bjornburton/champbot/README.md

Champ-like ROV, with brief submersion capability, designed to meet the demands of the Champlain Mini Maker Faire's Champbot Challenge.

Team Name: <discuss>
Team Members: Father and son, so far

This project will be on a very tight budget but the intent is to win!
