bjornburton/champbot/Firmware/jawAndFireControl/jafco.pdf

§1 | JAFCO | INTRODUCTION | 1

September 23, 2015 at 21:20

1. | Introduction. | This is the firmware portion of Jaw and Fire control.
This will facilitate two actions: opening the jaw to release the floating object and light the target on fire. The jaw will close by return-spring so the action will to open it.
Fire is a sequence of opening the jaw, releasing the butane and firing the ignitor.

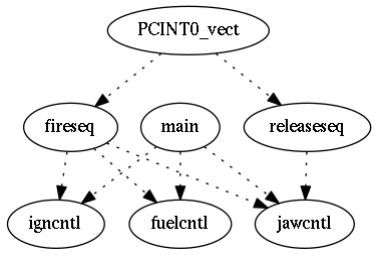
[picture p3: figure]

Extensive use was made of the datasheet, Atmel “Atmel ATtiny25, ATtiny45, ATtiny85 Datasheet” Rev. 2586QAVR08/2013 (Tue 06 Aug 2013 03:19:12 PM EDT) and “AVR130: Setup and Use the AVR Timers” Rev. 2505AAVR02/02.
hInclude 4 i
hPrototypes 5 i
h Global variables 6 i
2. "F_CPU" is used to convey the Trinket clock rate. #define F_CPU 8000000UL
3. Here are some Boolean definitions that are used. #define ON 1
#define OFF 0

#define OPEN 1

#define CLOSE 0

#define SET 1

#define CLEAR 0

2 | INTRODUCTION | JAFCO | §4

### 4. hInclude 4 i ≡

#include <avr/io.h> | /∗ need some port access ∗/

#include <util/delay.h> | /∗ need to delay ∗/

#include <avr/interrupt.h> | /∗ have need of an interrupt ∗/

#include <avr/sleep.h> | /∗ have need of sleep ∗/

#include <avr/wdt.h> | /∗ have need of watchdog ∗/

#include <stdlib.h>

#include <stdint.h>

This code is used in section 1.

### 5. hPrototypes 5 i ≡

void jawcntl(uint8 t state ); | /∗ Jaw open and close ∗/
void fuelcntl(uint8 t state ); | /∗ Fuel on and off ∗/
void igncntl(uint8 t state ); | /∗ on and off ∗/
void releaseseq (void);
void fireseq (void);

This code is used in section 1.

6. My lone global variable is a function pointer. This lets me pass arguments to the actual interrupt handlers, should I need to. This pointer gets the appropriate function attached by one of the "ISR()" functions.
h Global variables 6 i ≡
void (∗handleirq )( ) = Λ;
int main(void)
{
hInitialize interrupts 28 i hInitialize pin inputs 27 i hInitialize pin outputs 26 i

This code is used in section 1.

7. Of course, any interrupt function requires that bit “Global Interrupt Enable” is set; usually done through calling sei(). Doing this after the pin setup is the best time.
sei( );
8. Rather than burning loops, waiting for something to happen, the “sleep” mode is used. The specific type of sleep is ‘idle’. In idle, execution stops but timers continue. Interrupts are used to wake it.
h Configure to wake upon interrupt 34 i
9. This is the loop that does the work. It should spend most of its time in sleep mode , comming out at each interrupt event.
for ( ; ; )
{
10. We don’t want anything cooking while we are asleap. igncntl(OFF);
fuelcntl(OFF);
jawcntl(CLOSE);
11. Now we wait in “idle” for any interrupt event. sleep mode ( );

§12 | JAFCO | INTRODUCTION | 3
12. If execution arrives here, some interrupt has been detected.
if (handleirq 6= Λ) /∗ not sure why it would be, but to be safe ∗/
{
handleirq ( );
handleirq = Λ; | /∗ reset so that the action cannot be repeated ∗/
} | /∗ end if handleirq ∗/
} | /∗ end for ∗/
return 0; | /∗ it’s the right thing to do! ∗/
} | /∗ end main() ∗/

4 | INTERRUPT HANDLING | JAFCO | §13
13. Interrupt Handling.
void releaseseq ( )
{
14. This sequence will proceed only while the button is held. jawcntl(OPEN);
while (¬(PINB & (1 PB3))) delay ms (10); jawcntl(CLOSE); }

15.
void fireseq ( )
{
uint8 t firingstate ;
enum firingstates {
ready , opened , warned , igniting , burning };
firingstate = ready ;
16. This sequence will proceed only while the button is held. It can terminate after any state. "_delay_ms()" is a handy macro good for 2¹⁶ milliseconds of delay.

while (¬(PINB & (1 PB4))) {

17. The jaw opens here for fire, but also partly as a warning. if (firingstate ≡ ready ) {
jawcntl(OPEN);
firingstate = opened ;
continue;
}
18. Three warning bursts from the ignitor and then a 1000 ms duck delay. if (firingstate ≡ opened ) {
for (int8 t count = 0; count < 3; count ++) {
igncntl(ON);
delay ms (100);
igncntl(OFF);
delay ms (200);
}
delay ms (1000); /∗ human duck time ∗/ firingstate = warned ;
continue;
}
19. Fuel opens for precharge, then some delay. if (firingstate ≡ warned ) {
fuelcntl(ON);
delay ms (500);
firingstate = igniting ;
continue;
}

§20 | JAFCO | INTERRUPT HANDLING | 5
20. Ignitor on, delay a short time.
if (firingstate ≡ igniting ) {
igncntl(ON);
delay ms (250);
igncntl(OFF);
firingstate = burning ;
continue;
}
21. We should have fire now, but will tend it in case of wind. if (firingstate ≡ burning ) {
delay ms (1000);
igncntl(ON);
delay ms (200);
igncntl(OFF);
continue;
}
}
22. Once the loop fails we set fuel and ignitor off and close the jaw. igncntl(OFF);
fuelcntl(OFF);
jawcntl(CLOSE); }

6 | THE ISRS | JAFCO | §23
23. The ISRs.
The ISRs are pretty skimpy as they mostly used to point handleirq ( ) to the correct function. The need for global variables is minimized.
24. This vector responds to the jaw input at pin PB3 or fire input at PB4. A simple debounce is included. ISR(PCINT0 vect)
{
const int8 t high = 32;
const int8 t low = −high ; int8 t dbp3 = 0;
int8 t dbp4 = 0;
while (abs (dbp3 ) < high ) {
if (¬(PINB & (1 PB3)) ∧ dbp3 > low) dbp3 −−; else if ((PINB & (1 PB3)) ∧ dbp3 < high ) dbp3 ++; delay ms (1);
}
while (abs (dbp4 ) < high ) {
if (¬(PINB & (1 PB4)) ∧ dbp4 > low) dbp4 −−; else if ((PINB & (1 PB4)) ∧ dbp4 < high ) dbp4 ++; delay ms (1);
}
if (dbp3 ≡ low) handleirq = &releaseseq ;
else if (dbp4 ≡ low) handleirq = &fireseq ; }

§25 | JAFCO THESE ARE THE SUPPORTING ROUTINES, PROCEDURES AND CONFIGURATION BLOCKS | 7
25. These are the supporting routines, procedures and configuration blocks.
Here is the block that sets-up the digital I/O pins.

### 26. hInitialize pin outputs 26 i ≡

{ | /∗ set the jaw port direction ∗/
DDRB |= (1 DDB0); | /∗ set the fuel port direction ∗/
DDRB |= (1 DDB1); | /∗ set the ignition port direction ∗/
DDRB |= (1 DDB2);
}

This code is used in section 6.

### 27. hInitialize pin inputs 27 i ≡

{ | /∗ set the jaw input pull-up ∗/
PORTB |= (1 PORTB3); | /∗ set the fire input pull-up ∗/
PORTB |= (1 PORTB4);
}

This code is used in section 6.

### 28. hInitialize interrupts 28 i ≡

{ | /∗ enable change interrupt for jaw input ∗/
PCMSK |= (1 PCINT3); | /∗ enable change interrupt for fire input ∗/
PCMSK |= (1 PCINT4); | /∗ General interrupt Mask register ∗/
GIMSK |= (1 PCIE);
}

This code is used in section 6.

29. Here is a simple procedure to operate the jaw.
void jawcntl(uint8 t state )
{
PORTB = state ? PORTB | (1 PORTB0) : PORTB & ∼(1 PORTB0);
}
30. Here is a simple procedure to operate the fuel.
void fuelcntl(uint8 t state )
{
PORTB = state ? PORTB | (1 PORTB1) : PORTB & ∼(1 PORTB1);
}
31. Here is a simple procedure to operate the ignition.
void igncntl(uint8 t state )
{
PORTB = state ? PORTB | (1 PORTB2) : PORTB & ∼(1 PORTB2);
}
32. See section the datasheet for details on the Watchdog Timer. We are not using it right now.

### 33. hInitialize watchdog timer 33 i ≡

{
WDTCR |= (1 WDCE) | (1 WDE);
WDTCR = (1 WDIE) | (1 WDP2); /∗ reset after about 0.25 seconds ∗/
}

8 | THESE ARE THE SUPPORTING ROUTINES, PROCEDURES AND CONFIGURATION BLOCKS JAFCO | §34
34. Setting these bits configure sleep mode() to go to “idle”. Idle allows the counters and comparator to continue during sleep.
h Configure to wake upon interrupt 34 i ≡
{
MCUCR &= ∼(1 SM1);
MCUCR &= ∼(1 SM0);
}

This code is used in section 8.
delay ms : 14, 18, 19, 20, 21, 24. abs : 24.
burning : 15, 20, 21.
CLEAR: 3.
CLOSE: 3, 10, 14, 22.
count: 18.
dbp3 : 24.
dbp4 : 24.
DDB0: 26.
DDB1: 26.
DDB2: 26.
DDRB: 26.
F_CPU: 2.
fireseq : 5, 15, 24.
firingstate : 15, 17, 18, 19, 20, 21. firingstates: 15.
fuelcntl : 5, 10, 19, 22, 30. GIMSK: 28.
handleirq : 6, 12, 23, 24.
high : 24.
igncntl : 5, 10, 18, 20, 21, 22, 31. igniting : 15, 19, 20.
int8 t: 18, 24.
ISR: 24.
jawcntl : 5, 10, 14, 17, 22, 29. low: 24.
main: 6.
MCUCR: 34.
OFF: 3, 10, 18, 20, 21, 22. ON: 3, 18, 19, 20, 21.
OPEN: 3, 14, 17.
opened : 15, 17, 18.
PB3: 14, 24.
PB4: 16, 24.
PCIE: 28.
PCINT0 vect: 24.
PCINT3: 28.
PCINT4: 28.
PCMSK: 28.
PINB: 14, 16, 24.
PORTB: 27, 29, 30, 31.
PORTB0: 29.
PORTB1: 30.

PORTB2: 31.
PORTB3: 27.
PORTB4: 27.
ready : 15, 17.
releaseseq : 5, 13, 24.
sei : 7.
SET: 3.
sleep mode : 9, 11.
SM0: 34.
SM1: 34.
state : 5, 29, 30, 31.
uint8 t: 5, 15, 29, 30, 31. warned : 15, 18, 19.
WDCE: 33.
WDE: 33.
WDIE: 33.
WDP2: 33.
WDTCR: 33.

JAFCO | NAMES OF THE SECTIONS | 9

h Configure to wake upon interrupt 34 i Used in section 8.
h Global variables 6 i Used in section 1.
hInclude 4 i Used in section 1.
hInitialize interrupts 28 i Used in section 6.
hInitialize pin inputs 27 i Used in section 6. hInitialize pin outputs 26 i Used in section 6. hInitialize watchdog timer 33 i
hPrototypes 5 i Used in section 1.
