bjornburton/champbot/Firmware/Propulsion/piruett.pdf

§1 | PIRUETT | INTRODUCTION | 1

August 12, 2015 at 08:55

1. | Introduction. | This is the firmware portion of the propulsion system for our Champbot. It features
separate thrust and steering as well as piruett turning.
This will facilitate motion by taking “thrust” and “radius” pulse-width, or PWC, inputs from the Futaba-Kyosho RC receiver and converting them to the appropriate motor actions. Thrust is Channel 2, entering analog input A1, and Radius is channel 1, at A0. The action will be similar to driving an RC car or boat. By keeping it natural, it should be easier to navigate the course than with a skid-steer style control.
We are using the Wingxing DBH-01 (B/C) and the Inputs are unique on this. The PWM logic input goes to two different pins, depending on direction! The non-PWM pin must be held low. This is a big problem since PWM outputs have dedicated pins. Two AVR timers would be needed to control two motors; waistful. The odd example in the datasheet has PWM on IN1 and LOW on IN2 for forward. For reverse, LOW on IN1 and PWM on IN2.
Rulling out multiple timers (four comparators), additional outputs, or a PLD, the best solution we could find was a adding glue logic. A single 74F02 was chosen; a quad NOR. Keeping is this simple, one gate-type

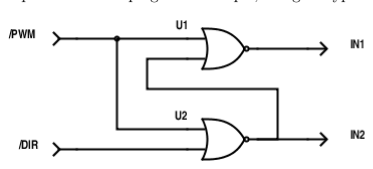
[picture p4: figure]

and one chip, required that the AVR outputs be inverted. | a
This one chip handles the logic for both motors. With this, the AVR outputs direction on one pin and PWM
on the other. At the H-Bridge, the pin receiving PWM is selected based on motor direction. The remaining,
non-PWM pin, is held low.
OC0A and OC0B is on pins 5 and 6 (D8 and D6) and are the PWM. A fail-safe relay output will be at pin 8.

2 | IMPLEMENTATION | PIRUETT | §2
2. | Implementation. | The Futaba receiver has two PWC channels. The pulse-width from the receiver
is at 20 ms intervals. The on-time ranges from 1000–2000 µs including trim. 1500 µs is the pulse-width for stop. The levers cover ±400 µs and the trim covers the last 100 µs.
The median time will be subtracted from them for a pair of signed values thrust and radius. The value will be scaled.
The thrust and radius will be translated to power to the port and starboard motors. When near median the motors will be disabled through a dead-band. Stiction in the motor probably wouldn’t allow it to move anyway, at this low duty-cycle. Both the PWM and safety relay will open. The motors will also be disabled when there are no input pulses; in this way champ wont run-off if the range is exceeded. This function is handled by the watchdog timer.
The radius control will also be the rotate control, if thrust is zero. Timer-Counter 0 is used for the PWM. The ATmega328 has a 16 bit PWMs with two comparators, Timer 1. This has an “Input Capture Unit” that may be used for PWC decoding. PWC being the type of signal from the RC receiver. That seems like as elegant a solution as I will find and it is recommended by Atmel to use it for this purpose.
The best way to use this nice feature is to take the PWC signals into the MUX, through the comparator and into the Input Capture Unit.
For the PWC measurement, this app note, AVR135, is helpful: www.atmel.com/images/doc8014.pdf In the datasheet, this section is helpful: 16.6.3
An interesting thing about this Futaba receiver is that the pulses are in series. The channel two’s pulse is first, followed the channel one. In fact, channel two’s fall is perfectly aligned with channel one’s rise. This means that it will be possible to capture all of the pulses.
After the two pulses are captured, there’s an 18 ms dead-time before the next round. That’s over 250,000 clock cycles. This will provide ample time to do math and set the motor PWMs.
Extensive use was made of the datasheet, Atmel “Atmel-8271I-AVR- ATmega-Datasheet 10/2014”.

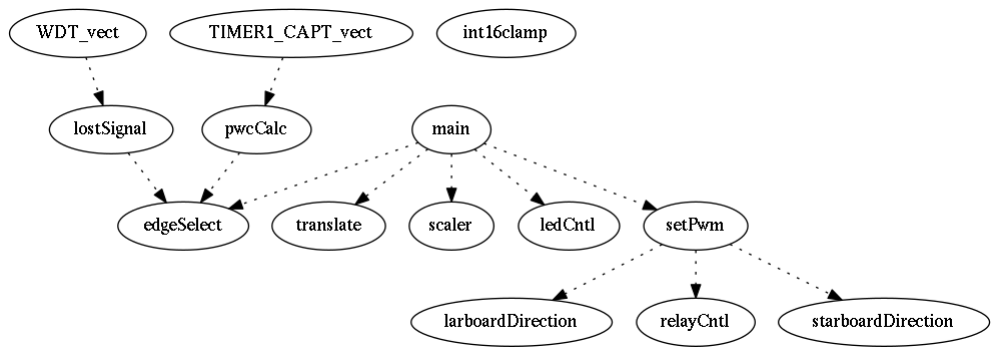
[picture p5: figure]

I originaly wanted to use the word ”Port” for the left-hand side, when facing the front. On a microcontroller that name is used for all of the ports so I chose the older word “larboard”.
hInclude 6 i
h Types 7 i
hPrototypes 9 i
h Global variables 10 i
3. "F_CPU" is used to convey the Trinket Pro clock rate. #define F_CPU 16000000UL

§4 | PIRUETT | IMPLEMENTATION | 3
4. Here are some Boolean definitions that are used.
#define ON 1

#define OFF 0

#define SET 1

#define CLEAR 0

#define TRUE 1

#define FALSE 0

#define FORWARD 1

#define REVERSE 0

#define CLOSED 1

#define OPEN 0

#define STOPPED 0

5. Here are some other definitions. #define CH2RISE 0
#define CH2FALL 1

#define CH1FALL 2

#define MAX_DUTYCYCLE 98 /∗ 98% to support charge pump of bridge-driver ∗/

### 6. hInclude 6 i ≡

#include <avr/io.h> | /∗ need some port access ∗/

#include <avr/interrupt.h> | /∗ have need of an interrupt ∗/

#include <avr/sleep.h> | /∗ have need of sleep ∗/

#include <avr/wdt.h> | /∗ have need of watchdog ∗/

#include <stdlib.h>

#include <stdint.h>

This code is used in section 2.

7. Here is a structure type to keep track of the state of remote-control input, e.g. servo timing. Rise and Fall indicate the PWC edges. "edge" is set to the edge type expected for the interrupt.
h Types 7 i ≡
typedef struct {
uint16 t ch2rise ;
uint16 t ch2fall ;
uint16 t ch1fall ;
uint16 t ch1duration;
uint16 t ch2duration;
uint8 t edge ;
uint8 t lostSignal ;
const uint16 t minIn; | /∗ input, minimum ∗/
const uint16 t maxIn; | /∗ input, maximum ∗/
} inputStruct;

See also section 8.

This code is used in section 2.

4 | IMPLEMENTATION | PIRUETT | §8
8. Here is a structure type to keep track of the state of translation items.
h Types 7 i +≡
typedef struct {
int16 t thrust; | /∗ -255 to 255 ∗/
int16 t radius ; | /∗ -255 to 255 ∗/
int16 t track ; | /∗ 1 to 255 ∗/
int16 t starboardOut; | /∗ -255 to 255 ∗/
int16 t larboardOut; | /∗ -255 to 255 ∗/
const int16 t minOut; | /∗ output, minimum ∗/
const int16 t maxOut; | /∗ output, maximum ∗/
const int8 t deadBand ; | /∗ width of zero in terms of output units ∗/
} transStruct;

### 9. hPrototypes 9 i ≡

void relayCntl(int8 t state );
void ledCntl(int8 t state );
void larboardDirection(int8 t state ); void starboardDirection(int8 t state ); void pwcCalc(inputStruct ∗); void edgeSelect(inputStruct ∗); void translate (transStruct ∗);
void setPwm(transStruct ∗);
void lostSignal(inputStruct ∗);
int16 t scaler (inputStruct ∗, transStruct ∗, uint16 t input); int16 t int16clamp(int16 t value , int16 t min, int16 t max );

This code is used in section 2.

10. My lone global variable is a function pointer. This lets me pass arguments to the actual interrupt handlers. This pointer gets the appropriate function attached by the "ISR()" function.
This input structure is to contain all of the external inputs.
h Global variables 10 i ≡
void(∗handleIrq )(inputStruct ∗) = Λ;
int main(void)
{

This code is used in section 2.

11. The Futaba receiver leads with channel two, rising edge, so we will start looking for that by setting "edge" to look for a rise on channel 2.
Center position of the controller results in a count of about 21250, hard left, or up, with trim reports about 29100 and hard right, or down, with trim reports about 13400.
About 4/5ths of that range are the full swing of the stick, without trim. This is from about 14970 and 27530 ticks.
".minIn" ".maxIn" are the endpoints of the normal stick travel. The units are raw counnts as the Input Capture Register will use.
At some point a calibration feature could be added which could populate these but the numbers here were from trial and error and seem good.
Until we have collected the edges we will assume there is no signal.
inputStruct input s = { . edge = CH2RISE , . minIn = 14970 , . maxIn = 27530 , . lostSignal = TRUE } ;

§12 | PIRUETT | IMPLEMENTATION | 5
12. This is the structure that holds output parameters. It’s instantiated with the endpoint constants. transStruct translation s = { . minOut = −255 , . maxOut = 255 , . deadBand = 10 } ;
13. Here the interrupts are disabled so that configuring them doesn’t set it off.
cli( );
hInitialize the inputs and capture mode 48 ihInitialize pin outputs 45 ihInitialize watchdog timer 50 i
14. Any interrupt function requires that bit “Global Interrupt Enable” is set; usually done through calling "sei()".
sei( );

15.
The PWM is used to control larboard and starboard motors through OC0A (D5) and OC0B (D6), respectivly.
hInitialize the Timer Counter 0 for PWM 52 i
16. Rather than burning loops, waiting the ballance of 18 ms for something to happen, the "sleep" mode is used. The specific type of sleep is "idle". In idle, execution stops but timers, like the Input Capture Unit and PWM continue to operate. Interrupts, either Input Capture or Watchdog , are used to wake it up. It’s important to note that an ISR procedure must be defined to allow the program to step past the sleep statement, even if it is empty. This stumped me for a good while.
h Configure to idle on sleep 46 i
ledCntl(OFF);
17. Since "edge" is already set, calling edgeSelect( ) will get it ready for the first rising edge of channel 2. Subsequent calls to edgeSelect rotates it to the next edge type.
edgeSelect(&input s );
18. This is the loop that does the work. It should spend most of its time in “sleep mode”, comming out at each interrupt event caused by an edge or watchdog timeout.
for ( ; ; ) {
19. Now that a loop is started, the PWM is value and we wait in "idle" for the edge on the channel selected. Each sucessive loop will finish in the same way. After three passes "translation_s" will have good values.
setPwm(&translation s );
sleep mode ( );

6 | IMPLEMENTATION | PIRUETT | §20
20. If execution arrives here, some interrupt has woken it from sleep and some vector has possibly run. The possibility is first checked. The pointer "handleIrq" will be assigned the value of the responsible function and then executed. After that the IRQ is nulled so as to avoid repeating the action, should it wake for some other reason.
if (handleIrq 6= Λ) {
handleIrq (&input s );
handleIrq = Λ;
}
translation s .radius = scaler (&input s , &translation s , input s .ch1duration); translation s .thrust = scaler (&input s , &translation s , input s .ch2duration); translation s .track = 100; /∗ represents unit-less prop-to-prop distance ∗/ translate (&translation s );
21. The LED is used to indicate both channels PWM’s are zeros.
if (translation s .larboardOut ∨ translation s .starboardOut) ledCntl(OFF); else ledCntl(ON);
} /∗ end for ∗/
return 0;
} /∗ end main() ∗/

§22 | PIRUETT | SUPPORTING ROUTINES, FUNCTIONS, PROCEDURES AND CONFIGURATION BLOCKS | 7
22. Supporting routines, functions, procedures and configuration blocks.
23. Here is the ISR that fires at each captured edge. Escentialy it grabs and processes the Input Capture data.
ISR(TIMER1 CAPT vect)
{
handleIrq = &pwcCalc;
}
24. When the watchdog timer expires, this vector is called. This is what happens if the remote’s transmitter signal is not received. It calls a variant of pwcCalc that only flips the lostSignal flag.
ISR(WDT vect)
{
handleIrq = &lostSignal ;
}
25. This procedure computes the durations from the PWC signal edge capture values from the Input Capture Unit. With the levers centered the durations should be about 1500 µs so at 16 Mhz the count should be near 24000. The range should be 17600 to 30400 for 12800 counts, well within the range of the 64 kib of the 16 bit register..
void pwcCalc(inputStruct ∗input s )
{
26. On the falling edges we can compute the durations using modulus subtraction and then set the edge index for the next edge. Channel 2 leads so that rise is first.
Arrival at the last case establishes that there was a signal, clears the flag and resets the watchdog timer. switch (input s~
edge ) {
case CH2RISE: input s~

ch2rise = ICR1;
input s~

edge = CH2FALL;
break;
case CH2FALL: input s~

ch2fall = ICR1;
input s~
ch2duration = input s~

ch2fall − input s~
ch2rise ;
input s~

edge = CH1FALL;
break;
case CH1FALL: input s~

ch1fall = ICR1;
input s~

ch1duration = input s~

ch1fall − input s~
ch2fall ;
input s~
edge = CH2RISE;
input s~

lostSignal = FALSE;
| wdt reset( ); | /∗ watchdog timer is reset at each edge capture ∗/
}
edgeSelect(input s );
}

8 | SUPPORTING ROUTINES, FUNCTIONS, PROCEDURES AND CONFIGURATION BLOCKS | PIRUETT | §27
27. This procedure sets output to zero in the event of a lost signal.
void lostSignal(inputStruct ∗input s )
{
input s~

lostSignal = TRUE;
input s~

edge = CH2RISE;
edgeSelect(input s );
}

28.
The procedure edgeSelect configures the "Input Capture" unit to capture on the expected edge type. void edgeSelect(inputStruct ∗input s )
{
switch (input s~

edge ) {
case CH2RISE: | /∗ To wait for rising edge on servo-channel 2 ∗/
ADMUX |= (1 MUX0); | /∗ Set to mux channel 1 ∗/
TCCR1B |= (1 ICES1); | /∗ Rising edge (23.3.2) ∗/
break;
case CH2FALL: ADMUX |= (1 MUX0); | /∗ Set to mux channel 1 ∗/
TCCR1B &= ∼(1 ICES1); | /∗ Falling edge (23.3.2) ∗/
break;
case CH1FALL: ADMUX &= ∼(1 MUX0); | /∗ Set to mux channel 0 ∗/
TCCR1B &= ∼(1 ICES1); | /∗ Falling edge (23.3.2) ∗/
}
29. Since the edge has been changed, the Input Capture Flag should be cleared. It seems odd but clearing it involves writing a one to it.
TIFR1 |= (1 ICF1); /∗ (per 16.6.3) ∗/
}

30.

31. The scaler function takes an input, in time, from the Input Capture Register and returns a value scaled by the parameters in structure "inputScale_s".
int16 t scaler (inputStruct ∗input s , transStruct ∗trans s , uint16 t input)
{
uint16 t solution;
32. First, we can solve for the obvious cases. One is where there is no signal; when "lostSignal" is "TRUE". The other is where the input exceeds the range. This can easily happen if the trim is shifted.
if (input s~
lostSignal ≡ TRUE) return 0; if (input > input s~maxIn) return trans s~maxOut;
if (input < input s~minIn) return trans s~minOut;

§33 | PIRUETT | SUPPORTING ROUTINES, FUNCTIONS, PROCEDURES AND CONFIGURATION BLOCKS | 9
33. If it’s not that simple, then compute the gain and offset and then continue in the usual way. This is not really an efficient method, recomputing gain and offset every time but we are not in a rush and it makes it easier since, if something changes, I don’t have to manualy compute and enter these value.
The constant "ampFact" amplifies values for math so I can take advantage of the extra bits for precision. Dead-band is applied when it returns.
const int32 t ampFact = 128L;
int32 t gain = (ampFact ∗ (int32 t)(input s~maxIn − input s~minIn))/(int32 t)(trans s~maxOut − trans s~minOut);
int32 t offset = ((ampFact ∗ (int32 t)input s~minIn)/gain) − (int32 t)trans s~minOut;
solution = (ampFact ∗ (int32 t)input /gain) − offset;
return (abs (solution) > trans s~

deadBand ) ? solution : 0; }

34. We need a way to translate "thrust" and "radius" in order to carve a "turn". This procedure should do this but it’s not going to be perfect as drag and slippage make thrust increase progressivly more than speed. Since speed is not known, we will use thrust. It should steer OK as long as the speed is constant and small changes in speed should not be too disruptive. The sign of larboardOut and starboardOut indicates direction. The constant "ampFact" amplifies values for math so I can take advantage of the extra bits for precision. bits.
This procedure is intended for values from -255 to 255.
"max" is set to support the limit of the bridge-driver’s charge-pump.
void translate (transStruct ∗trans s )
{
int16 t speed = trans s~

thrust; /∗ we are assuming it’s close ∗/ int16 t rotation;
int16 t difference ;
int16 t piruett;
static int8 t lock = OFF;
const int8 t PirLockLevel = 15;
const int16 t max = (MAX_DUTYCYCLE ∗ UINT8_MAX)/100;
const int16 t ampFact = 128;
35. Here we convert desired radius to thrust-difference by scaling to speed. Then that difference is converted to rotation by scaling it with "track". The radius sensitivity is adjusted by changing the value of "track".
difference = (speed ∗ ((ampFact ∗ trans s~

radius )/UINT8_MAX))/ampFact; rotation = (trans s~
track ∗ ((ampFact ∗ difference )/UINT8_MAX))/ampFact; piruett = trans s~

radius ;

10 | SUPPORTING ROUTINES, FUNCTIONS, PROCEDURES AND CONFIGURATION BLOCKS PIRUETT | §36
36. Any rotation involves one motor turning faster than the other. At some point, faster is not possible and so the leading motor’s thrust is clipped.
If there is no thrust then it is in piruett mode and spins CW or CCW. While thrust is present, piruett mode is locked out. Piruett mode has a lock function too, to keep it from hopping into directly into thrust mode while it is spinning around. This is partly for noise immunity and partly to help avoid collisions.
if (trans s~

thrust 6= STOPPED ∧ lock ≡ OFF) {
trans s~

larboardOut = int16clamp(speed − rotation, −max , max ); trans s~

starboardOut = int16clamp(speed + rotation, −max , max ); }
else /∗ piruett mode ∗/
{ lock = (abs (piruett) > PirLockLevel) ? ON : OFF;
trans s~

larboardOut = int16clamp(piruett, −max , max );

37. For starboard, piruett is reversed, making it rotate counter to larboard. piruett = −piruett;
trans s~

starboardOut = int16clamp(piruett, −max , max ); } }

38. This procedure sets the signal to the H-Bridge. For the PWM we load the value into the unsigned registers.
void setPwm(transStruct ∗trans s )
{
if (trans s~

larboardOut ≥ 0) {
larboardDirection(FORWARD); OCR0A = abs (trans s~
larboardOut);
}
else {
larboardDirection(REVERSE); OCR0A = abs (trans s~
larboardOut);
}
if (trans s~
starboardOut ≥ 0) {
starboardDirection(FORWARD); OCR0B = abs (trans s~
starboardOut);
}
else {
starboardDirection(REVERSE); OCR0B = abs (trans s~
starboardOut);
}
39. We must see if the fail-safe relay needs to be closed. if (trans s~
larboardOut ∨ trans s~

starboardOut) relayCntl(CLOSED); else relayCntl(OPEN);
}

§40 | PIRUETT SUPPORTING ROUTINES, FUNCTIONS, PROCEDURES AND CONFIGURATION BLOCKS | 11
40. Here is a simple procedure to flip the LED on or off.
void ledCntl(int8 t state )
{
PORTB = state ? PORTB | (1 PORTB5) : PORTB & ∼(1 PORTB5);
}
41. Here is a simple procedure to flip the Relay Closed or Open from pin #8. void relayCntl(int8 t state )
{
PORTB = state ? PORTB | (1 PORTB0) : PORTB & ∼(1 PORTB0);
}
42. Here is a simple procedure to set thrust direction on the larboard motor. void larboardDirection(int8 t state )
{
if (state ) PORTD &= ∼(1 PORTD3);
else PORTD |= (1 PORTD3);
}
43. Here is a simple procedure to set thrust direction on the starboard motor. void starboardDirection(int8 t state )
{
if (state ) PORTD &= ∼(1 PORTD4);
else PORTD |= (1 PORTD4);
}
44. A simple 16 bit clamp function.
int16 t int16clamp(int16 t value , int16 t min, int16 t max )
{
return (value > max ) ? max : (value < min) ? min : value ;
}
45. | hInitialize pin outputs 45 i ≡ | /∗ set the led port direction; This is pin #17 ∗/
DDRB |= (1 DDB5); | /∗ set the relay port direction; This is pin #8 ∗/
DDRB |= (1 DDB0); | /∗ 14.4.9 DDRD The Port D Data Direction Register ∗/
/∗ larboard and starboard pwm outputs ∗/
DDRD |= ((1 DDD5) | (1 DDD6)); /∗ Data direction to output (sec 14.3.3) ∗/
/∗ larboard and starboard direction outputs ∗/
DDRD |= ((1 DDD3) | (1 DDD4)); /∗ Data direction to output (sec 14.3.3) ∗/

This code is used in section 13.

### 46. h Configure to idle on sleep 46 i ≡

{
SMCR &= ∼((1 SM2) | (1 SM1) | (1 SM0));
}

This code is used in section 16.

12 | SUPPORTING ROUTINES, FUNCTIONS, PROCEDURES AND CONFIGURATION BLOCKS PIRUETT | §52
47. To enable this interrupt, set the ACIE bit of register ACSR.

### 48. hInitialize the inputs and capture mode 48 i ≡

{ | /∗ ADCSRA ADC Control and Status Register A ∗/
ADCSRA &= ∼(1 ADEN); | /∗ Conn the MUX to (-) input of comparator (sec 23.2) ∗/
/∗ 23.3.1 ADCSRB ADC Control and Status Register B ∗/
ADCSRB |= (1 ACME); /∗ Conn the MUX to (-) input of comparator (sec 23.2) ∗/ /∗ 24.9.5 DIDR0 Digital Input Disable Register 0 ∗/
DIDR0 |= ((1 AIN1D) | (1 AIN0D)); /∗ Disable digital inputs (sec 24.9.5) ∗/
/∗ 23.3.2 ACSR Analog Comparator Control and Status Register ∗/
ACSR |= (1 ACBG); | /∗ Connect + input to the band-gap ref (sec 23.3.2) ∗/
ACSR |= (1 ACIC); | /∗ Enable input capture mode (sec 23.3.2) ∗/
ACSR |= (1 ACIS1); | /∗ Set for both rising and falling edge (sec 23.3.2) ∗/
/∗ 16.11.8 TIMSK1 Timer/Counter1 Interrupt Mask Register ∗/
TIMSK1 |= (1 ICIE1); /∗ Enable input capture interrupt (sec 16.11.8) ∗/
/∗ 16.11.2 TCCR1B Timer/Counter1 Control Register B ∗/
TCCR1B |= (1 ICNC1); | /∗ Enable input capture noise canceling (sec 16.11.2) ∗/
TCCR1B |= (1 CS10); | /∗ No Prescale. Just count the main clock (sec 16.11.2) ∗/
/∗ 24.9.1 ADMUX ADC Multiplexer Selection Register ∗/
ADMUX &= ∼((1 MUX2) | (1 MUX1) | (1 MUX0)); /∗ Set to mux channel 0 ∗/
}

This code is used in section 13.

49. See section 11.8 in the datasheet for details on the Watchdog Timer. This is in the “Interrupt Mode”.

### 50. hInitialize watchdog timer 50 i ≡

{
WDTCSR |= (1 WDCE) | (1 WDE);
WDTCSR = (1 WDIE) | (1 WDP2); /∗ reset after about 0.25 seconds ∗/
}

This code is used in section 13.

51. PWM setup isn’t too scary. Timer Count 0 is configured for “Phase Correct” PWM which, according to the datasheet, is preferred for motor control. OC0A (port) and OC0B (starboard) are set to clear on a match which creates a non-inverting PWM. The prescaler is set to clk/8 and with a 16 MHz clock the f is about 3922 Hz. We are using "Set" on comparator match to invert the PWM, suiting the glue-logic which drives the H-Bridge.

### 52. hInitialize the Timer Counter 0 for PWM 52 i ≡

{ | /∗ 15.9.1 TCCR0A Timer/Counter Control Register A ∗/
TCCR0A |= (1 WGM00); | /∗ Phase correct, mode 1 of PWM (table 15-9) ∗/
TCCR0A |= (1 COM0A1); | /∗ Set/Clear on Comparator A match (table 15-4) ∗/
TCCR0A |= (1 COM0B1); | /∗ Set/Clear on Comparator B match (table 15-7) ∗/
TCCR0A |= (1 COM0A0); | /∗ Set on Comparator A match (table 15-4) ∗/
TCCR0A |= (1 COM0B0); | /∗ Set on Comparator B match (table 15-7) ∗/
/∗ 15.9.2 TCCR0B Timer/Counter Control Register B ∗/
TCCR0B |= (1 CS01); /∗ Prescaler set to clk/8 (table 15-9) ∗/
}

This code is used in section 15.
abs : 33, 36, 38.

ACBG: 48.

ACIC: 48.

ACIS1: 48.

§52 | PIRUETT SUPPORTING ROUTINES, FUNCTIONS, PROCEDURES AND CONFIGURATION BLOCKS | 13

ACME: 48.
ACSR: 48.
ADCSRA: 48.
ADCSRB: 48.
ADEN: 48.
ADMUX: 28, 48.
AIN0D: 48.
AIN1D: 48.
ampFact: 33, 34, 35.
Capture : 16, 23.
ch1duration: 7, 20, 26.
ch1fall : 7, 26.
CH1FALL: 5, 26, 28.
ch2duration: 7, 20, 26.
ch2fall : 7, 26.
CH2FALL: 5, 26, 28.
CH2RISE: 5, 11, 26, 27, 28. ch2rise : 7, 26.
CLEAR: 4.
cli : 13.
CLOSED: 4, 39.
COM0A0: 52.
COM0A1: 52.
COM0B0: 52.
COM0B1: 52.
CS01: 52.
CS10: 48.
DDB0: 45.
DDB5: 45.
DDD3: 45.
DDD4: 45.
DDD5: 45.
DDD6: 45.
DDRB: 45.
DDRD: 45.
deadBand : 8, 12, 33.
DIDR0: 48.
difference : 34, 35.
edge : 7, 11, 26, 27, 28.
edgeSelect: 9, 17, 26, 27, 28. F_CPU: 3.
FALSE: 4, 26.
FORWARD: 4, 38.
gain: 33.
handleIrq : 10, 20, 23, 24. ICES1: 28.
ICF1: 29.
ICIE1: 48.
ICNC1: 48.
ICR1: 26.
Input: 16, 23.
input: 9, 31, 32, 33.

input s : 11, 17, 20, 25, 26, 27, 28, 31, 32, 33. inputStruct: 7, 9, 10, 11, 25, 27, 28, 31. int16 t: 8, 9, 31, 34, 44.
int16clamp: 9, 36, 37, 44.
int32 t: 33.
int8 t: 8, 9, 34, 40, 41, 42, 43. ISR: 23, 24.
larboardDirection: 9, 38, 42. larboardOut: 8, 21, 36, 38, 39. ledCntl : 9, 16, 21, 40.
lock : 34, 36.
lostSignal : 7, 9, 11, 24, 26, 27, 32. main: 10.
max : 9, 34, 36, 37, 44.
MAX_DUTYCYCLE: 5, 34.
maxIn: 7, 11, 32, 33.
maxOut: 8, 12, 32, 33.
min: 9, 44.
minIn: 7, 11, 32, 33.
minOut: 8, 12, 32, 33.
MUX0: 28, 48.
MUX1: 48.
MUX2: 48.
OCR0A: 38.
OCR0B: 38.
OFF: 4, 16, 21, 34, 36.
offset: 33.
ON: 4, 21, 36.
OPEN: 4, 39.
PirLockLevel : 34, 36.
piruett: 34, 35, 36, 37.
PORTB: 40, 41.
PORTB0: 41.
PORTB5: 40.
PORTD: 42, 43.
PORTD3: 42.
PORTD4: 43.
pwcCalc: 9, 23, 24, 25.
radius : 8, 20, 35.
relayCntl : 9, 39, 41.
REVERSE: 4, 38.
rotation: 34, 35, 36.
scaler : 9, 20, 31.
sei : 14.
SET: 4.
setPwm: 9, 19, 38.
sleep mode : 19.
SMCR: 46.
SM0: 46.
SM1: 46.
SM2: 46.
solution: 31, 33.

14 | SUPPORTING ROUTINES, FUNCTIONS, PROCEDURES AND CONFIGURATION BLOCKS PIRUETT | §52

speed : 34, 35, 36.
starboardDirection: 9, 38, 43.
starboardOut: 8, 21, 36, 37, 38, 39. state : 9, 40, 41, 42, 43.
STOPPED: 4, 36.
TCCR0A: 52.
TCCR0B: 52.
TCCR1B: 28, 48.
thrust: 8, 20, 34, 36.
TIFR1: 29.
TIMER1 CAPT vect: 23.
TIMSK1: 48.
track : 8, 20, 35.
trans s : 31, 32, 33, 34, 35, 36, 37, 38, 39. translate : 9, 20, 34.
translation s : 12, 19, 20, 21. transStruct: 8, 9, 12, 31, 34, 38. TRUE: 4, 11, 27, 32.
uint16 t: 7, 9, 31.
UINT8_MAX: 34, 35.
uint8 t: 7.
value : 9, 44.
Watchdog : 16.
WDCE: 50.
WDE: 50.
WDIE: 50.
WDP2: 50.
wdt reset: 26.
WDT vect: 24.
WDTCSR: 50.
WGM00: 52.

PIRUETT | NAMES OF THE SECTIONS | 15

h Configure to idle on sleep 46 i Used in section 16.
h Global variables 10 i Used in section 2.
hInclude 6 i Used in section 2.
hInitialize pin outputs 45 i Used in section 13.
hInitialize the Timer Counter 0 for PWM 52 i Used in section 15. hInitialize the inputs and capture mode 48 i Used in section 13. hInitialize watchdog timer 50 i Used in section 13.
hPrototypes 9 i Used in section 2.
h Types 7, 8 i Used in section 2.
