bjornburton/champbot/diagrammaticModels/Activities/igniteActivity.png

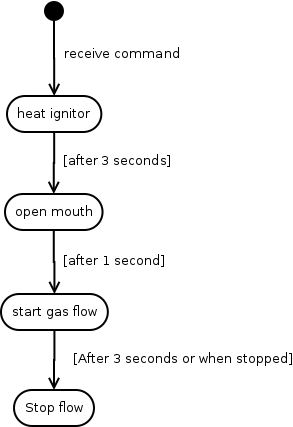
diagrammaticModels/Activities/igniteActivity.png
