bjornburton/champbot/diagrammaticModels/Activities/manageFloatActivity.png

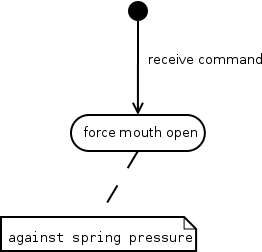
diagrammaticModels/Activities/manageFloatActivity.png
