bjornburton/champbot/diagrammaticModels/Activities/maneuverActivity.png

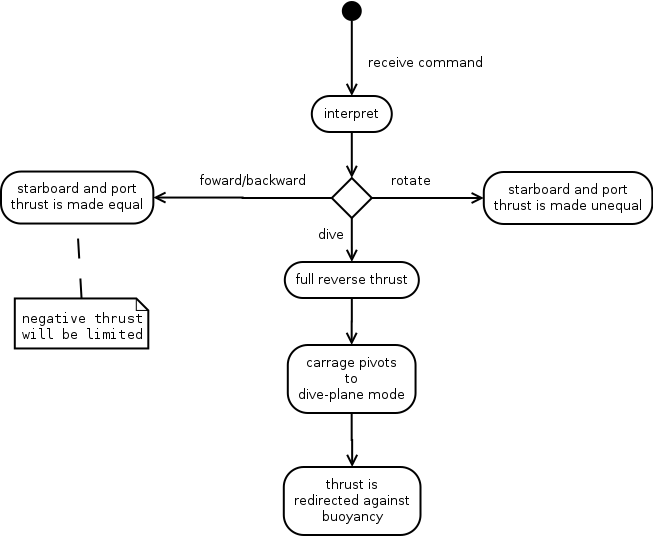
diagrammaticModels/Activities/maneuverActivity.png
