bjornburton/champbot/diagrammaticModels/Structure/Structure.png

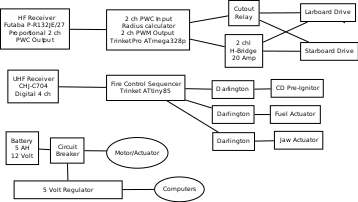
diagrammaticModels/Structure/Structure.png
