bjornburton/champbot/diagrammaticModels/useCase/essentialFunctionUseCase.png

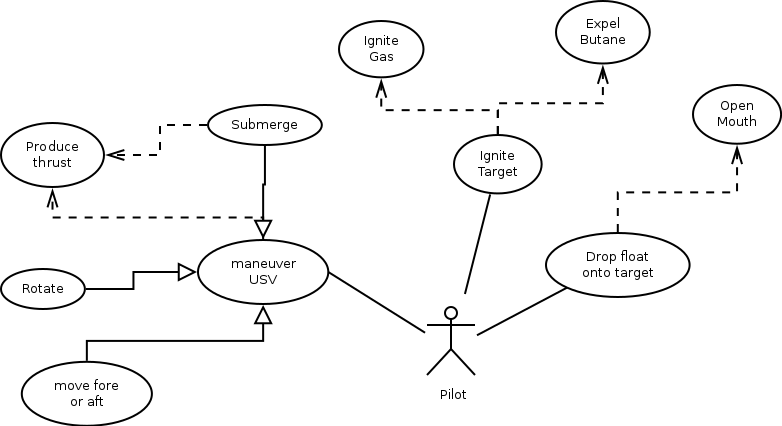
diagrammaticModels/useCase/essentialFunctionUseCase.png
