bjornburton/champbot/pictures/champBots.jpg

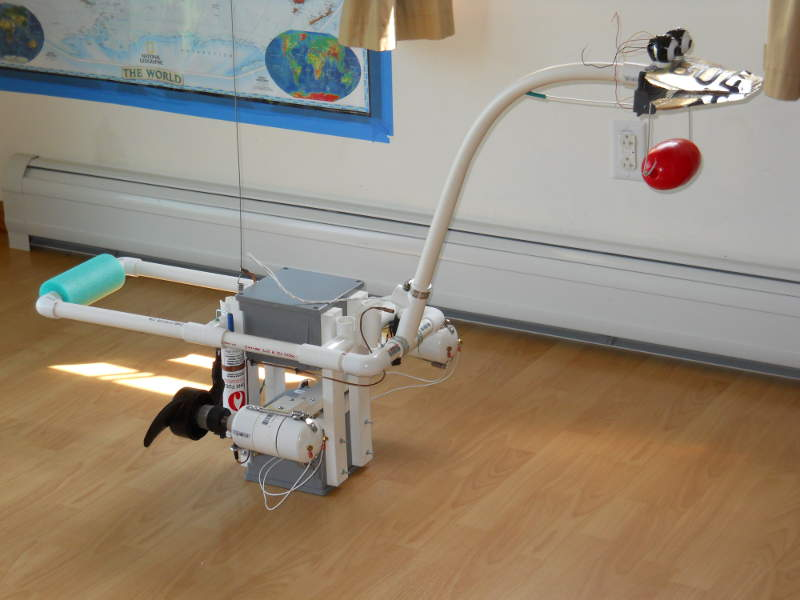
pictures/champBots.jpg
