bjornburton/champbot/pictures/electronicsBayBot1s.jpg

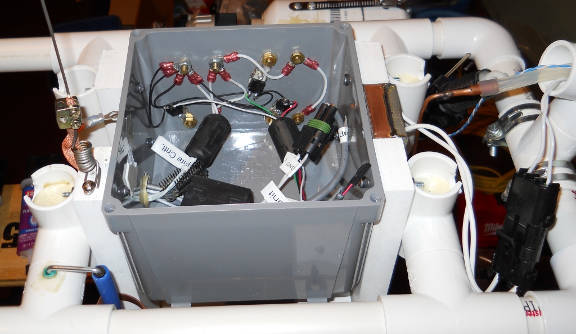
pictures/electronicsBayBot1s.jpg
