bjornburton/champbot/pictures/electronicsBayBot2s.jpg

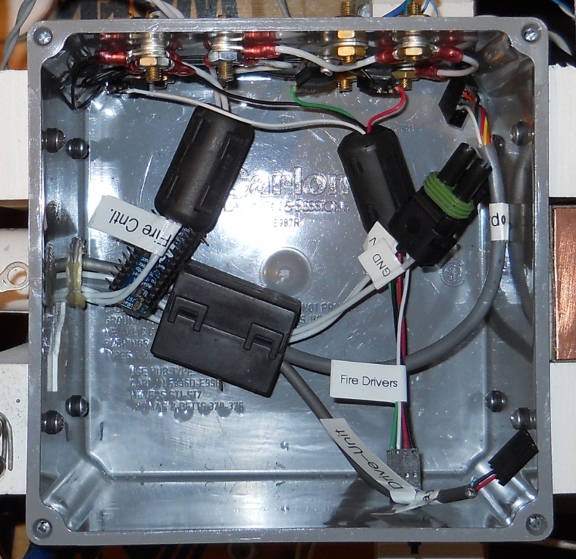
pictures/electronicsBayBot2s.jpg
