bjornburton/champbot/pictures/electronicsBayTops.jpg

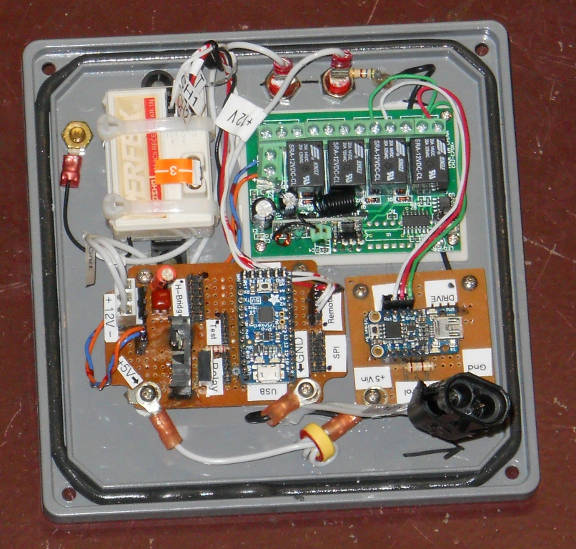
pictures/electronicsBayTops.jpg
