bjornburton/champbot/pictures/fireControlSequencers.jpg

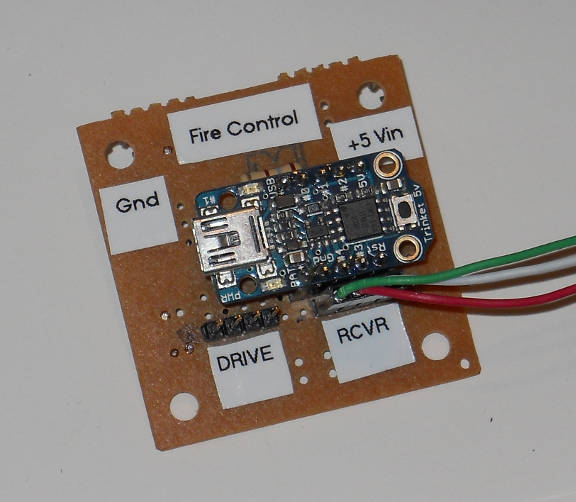
pictures/fireControlSequencers.jpg
