bjornburton/champbot/pictures/fireControlTransistor2s.jpg

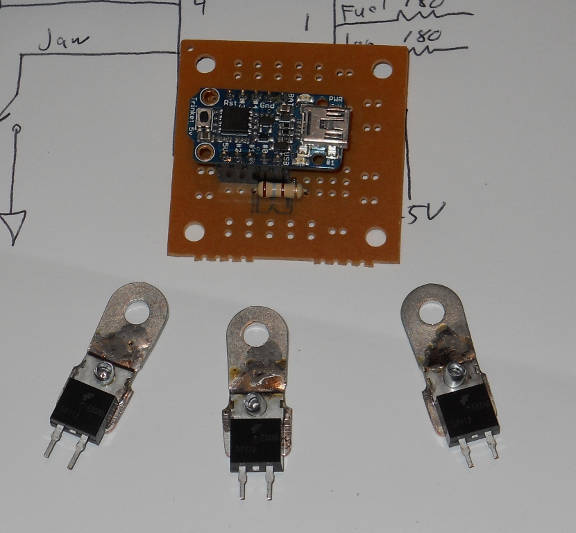
pictures/fireControlTransistor2s.jpg
