bjornburton/champbot/pictures/powerBayTops.jpg

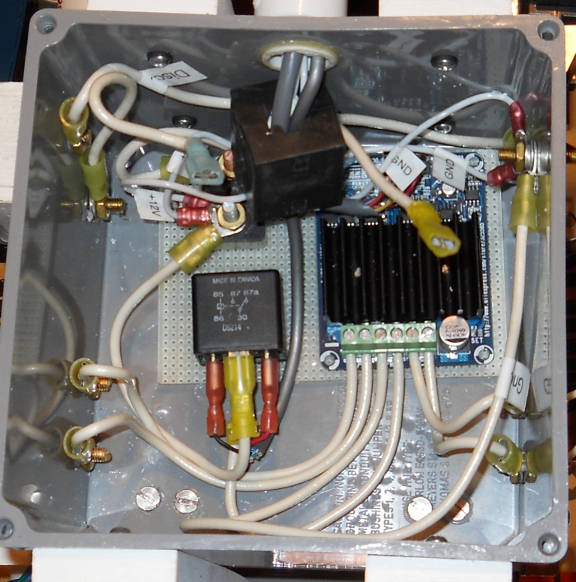
pictures/powerBayTops.jpg
