bjornburton/champbot/pictures/servoWaveforms.jpg

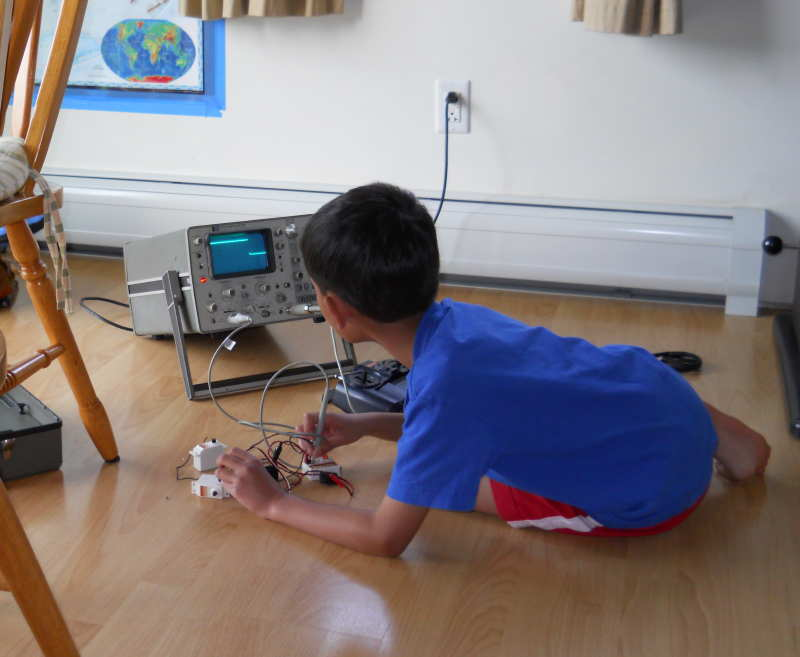
pictures/servoWaveforms.jpg
