bjornburton/champbot/Firmware/Propulsion/piruett.c

#define F_CPU 16000000UL \

#define ON 1
#define OFF 0
#define SET 1
#define CLEAR 0
#define TRUE 1
#define FALSE 0
#define FORWARD 1
#define REVERSE 0
#define CLOSED 1
#define OPEN 0
#define STOPPED 0 \

#define CH2RISE 0
#define CH2FALL 1
#define CH1FALL 2
#define MAX_DUTYCYCLE 98 \
 \

/*2:*/
#line 105 "./piruett.w"

/*6:*/
#line 134 "./piruett.w"

# include <avr/io.h>  
# include <avr/interrupt.h>  
# include <avr/sleep.h>  
# include <avr/wdt.h>  
# include <stdlib.h> 
# include <stdint.h> 

/*:6*/
#line 106 "./piruett.w"

/*7:*/
#line 146 "./piruett.w"

typedef struct{
uint16_t ch2rise;
uint16_t ch2fall;
uint16_t ch1fall;
uint16_t ch1duration;
uint16_t ch2duration;
uint8_t edge;
uint8_t lostSignal;
const uint16_t minIn;
const uint16_t maxIn;
}inputStruct;

/*:7*//*8:*/
#line 160 "./piruett.w"

typedef struct{
int16_t thrust;
int16_t radius;
int16_t track;
int16_t starboardOut;
int16_t larboardOut;
const int16_t minOut;
const int16_t maxOut;
const int8_t deadBand;
}transStruct;


/*:8*/
#line 107 "./piruett.w"

/*9:*/
#line 173 "./piruett.w"

void relayCntl(int8_t state);
void ledCntl(int8_t state);
void larboardDirection(int8_t state);
void starboardDirection(int8_t state);
void pwcCalc(inputStruct*);
void edgeSelect(inputStruct*);
void translate(transStruct*);
void setPwm(transStruct*);
void lostSignal(inputStruct*);
int16_t scaler(inputStruct*,transStruct*,uint16_t input);
int16_t int16clamp(int16_t value,int16_t min,int16_t max);

/*:9*/
#line 108 "./piruett.w"

/*10:*/
#line 193 "./piruett.w"

void(*handleIrq)(inputStruct*)= NULL;



int main(void)
{

/*:10*/
#line 109 "./piruett.w"


/*:2*//*11:*/
#line 219 "./piruett.w"


inputStruct input_s= {
.edge= CH2RISE,
.minIn= 14970,
.maxIn= 27530,
.lostSignal= TRUE
};


/*:11*//*12:*/
#line 232 "./piruett.w"

transStruct translation_s= {
.minOut= -255,
.maxOut= 255,
.deadBand= 10
};

/*:12*//*13:*/
#line 241 "./piruett.w"

cli();

/*48:*/
#line 692 "./piruett.w"

{

ADCSRA&= ~(1<<ADEN);


ADCSRB|= (1<<ACME);


DIDR0|= ((1<<AIN1D)|(1<<AIN0D));


ACSR|= (1<<ACBG);
ACSR|= (1<<ACIC);
ACSR|= (1<<ACIS1);


TIMSK1|= (1<<ICIE1);


TCCR1B|= (1<<ICNC1);
TCCR1B|= (1<<CS10);


ADMUX&= ~((1<<MUX2)|(1<<MUX1)|(1<<MUX0));
}

/*:48*/
#line 244 "./piruett.w"

/*45:*/
#line 669 "./piruett.w"


DDRB|= (1<<DDB5);



DDRB|= (1<<DDB0);




DDRD|= ((1<<DDD5)|(1<<DDD6));


DDRD|= ((1<<DDD3)|(1<<DDD4));

/*:45*/
#line 245 "./piruett.w"

/*50:*/
#line 722 "./piruett.w"

{

WDTCSR|= (1<<WDCE)|(1<<WDE);
WDTCSR= (1<<WDIE)|(1<<WDP2);
}

/*:50*/
#line 246 "./piruett.w"


/*:13*//*14:*/
#line 251 "./piruett.w"

sei();


/*:14*//*15:*/
#line 259 "./piruett.w"

/*52:*/
#line 738 "./piruett.w"

{

TCCR0A|= (1<<WGM00);
TCCR0A|= (1<<COM0A1);
TCCR0A|= (1<<COM0B1);
TCCR0A|= (1<<COM0A0);
TCCR0A|= (1<<COM0B0);


TCCR0B|= (1<<CS01);
}

/*:52*/
#line 260 "./piruett.w"



/*:15*//*16:*/
#line 274 "./piruett.w"


/*46:*/
#line 685 "./piruett.w"

{
SMCR&= ~((1<<SM2)|(1<<SM1)|(1<<SM0));
}

/*:46*/
#line 276 "./piruett.w"



ledCntl(OFF);

/*:16*//*17:*/
#line 285 "./piruett.w"

edgeSelect(&input_s);

/*:17*//*18:*/
#line 292 "./piruett.w"



for(;;)
{

/*:18*//*19:*/
#line 304 "./piruett.w"

setPwm(&translation_s);

sleep_mode();

/*:19*//*20:*/
#line 318 "./piruett.w"

if(handleIrq!=NULL)
{
handleIrq(&input_s);
handleIrq= NULL;
}



translation_s.radius= scaler(&input_s,&translation_s,input_s.ch1duration);
translation_s.thrust= scaler(&input_s,&translation_s,input_s.ch2duration);
translation_s.track= 100;

translate(&translation_s);

/*:20*//*21:*/
#line 335 "./piruett.w"

if(translation_s.larboardOut||translation_s.starboardOut)
ledCntl(OFF);
else
ledCntl(ON);


}



return 0;

}


/*:21*//*23:*/
#line 358 "./piruett.w"


ISR(TIMER1_CAPT_vect)
{
handleIrq= &pwcCalc;
}

/*:23*//*24:*/
#line 369 "./piruett.w"

ISR(WDT_vect)
{
handleIrq= &lostSignal;
}

/*:24*//*25:*/
#line 384 "./piruett.w"

void pwcCalc(inputStruct*input_s)
{
/*:25*//*26:*/
#line 394 "./piruett.w"



switch(input_s->edge)
{
case CH2RISE:
input_s->ch2rise= ICR1;
input_s->edge= CH2FALL;
break;
case CH2FALL:
input_s->ch2fall= ICR1;
input_s->ch2duration= input_s->ch2fall-input_s->ch2rise;
input_s->edge= CH1FALL;
break;
case CH1FALL:
input_s->ch1fall= ICR1;
input_s->ch1duration= input_s->ch1fall-input_s->ch2fall;
input_s->edge= CH2RISE;
input_s->lostSignal= FALSE;
wdt_reset();
}

edgeSelect(input_s);
}

/*:26*//*27:*/
#line 421 "./piruett.w"

void lostSignal(inputStruct*input_s)
{
input_s->lostSignal= TRUE;
input_s->edge= CH2RISE;

edgeSelect(input_s);
}

/*:27*//*28:*/
#line 435 "./piruett.w"

void edgeSelect(inputStruct*input_s)
{

switch(input_s->edge)
{
case CH2RISE:
ADMUX|= (1<<MUX0);
TCCR1B|= (1<<ICES1);
break;
case CH2FALL:
ADMUX|= (1<<MUX0);
TCCR1B&= ~(1<<ICES1);
break;
case CH1FALL:
ADMUX&= ~(1<<MUX0);
TCCR1B&= ~(1<<ICES1);
}
/*:28*//*29:*/
#line 456 "./piruett.w"


TIFR1|= (1<<ICF1);
}


/*:29*//*31:*/
#line 468 "./piruett.w"

int16_t scaler(inputStruct*input_s,transStruct*trans_s,uint16_t input)
{
uint16_t solution;
/*:31*//*32:*/
#line 477 "./piruett.w"

if(input_s->lostSignal==TRUE)
return 0;

if(input> input_s->maxIn)
return trans_s->maxOut;

if(input<input_s->minIn)
return trans_s->minOut;


/*:32*//*33:*/
#line 499 "./piruett.w"

const int32_t ampFact= 128L;

int32_t gain= (ampFact*(int32_t)(input_s->maxIn-input_s->minIn))/
(int32_t)(trans_s->maxOut-trans_s->minOut);

int32_t offset= ((ampFact*(int32_t)input_s->minIn)/gain)
-(int32_t)trans_s->minOut;

solution= (ampFact*(int32_t)input/gain)-offset;


return(abs(solution)> trans_s->deadBand)?solution:0;

}

/*:33*//*34:*/
#line 530 "./piruett.w"


void translate(transStruct*trans_s)
{
int16_t speed= trans_s->thrust;
int16_t rotation;
int16_t difference;
int16_t piruett;
static int8_t lock= OFF;
const int8_t PirLockLevel= 15;
const int16_t max= (MAX_DUTYCYCLE*UINT8_MAX)/100;
const int16_t ampFact= 128;


/*:34*//*35:*/
#line 548 "./piruett.w"

difference= (speed*((ampFact*trans_s->radius)/UINT8_MAX))/ampFact;
rotation= (trans_s->track*((ampFact*difference)/UINT8_MAX))/ampFact;
piruett= trans_s->radius;

/*:35*//*36:*/
#line 564 "./piruett.w"

if(trans_s->thrust!=STOPPED&&lock==OFF)
{
trans_s->larboardOut= int16clamp(speed-rotation,-max,max);
trans_s->starboardOut= int16clamp(speed+rotation,-max,max);
}
else
{
lock= (abs(piruett)> PirLockLevel)?ON:OFF;

trans_s->larboardOut= int16clamp(piruett,-max,max);
/*:36*//*37:*/
#line 577 "./piruett.w"

piruett= -piruett;
trans_s->starboardOut= int16clamp(piruett,-max,max);
}
}

/*:37*//*38:*/
#line 586 "./piruett.w"

void setPwm(transStruct*trans_s)
{

if(trans_s->larboardOut>=0)
{
larboardDirection(FORWARD);
OCR0A= abs(trans_s->larboardOut);
}
else
{
larboardDirection(REVERSE);
OCR0A= abs(trans_s->larboardOut);
}

if(trans_s->starboardOut>=0)
{
starboardDirection(FORWARD);
OCR0B= abs(trans_s->starboardOut);
}
else
{
starboardDirection(REVERSE);
OCR0B= abs(trans_s->starboardOut);
}

/*:38*//*39:*/
#line 614 "./piruett.w"

if(trans_s->larboardOut||trans_s->starboardOut)
relayCntl(CLOSED);
else
relayCntl(OPEN);

}

/*:39*//*40:*/
#line 624 "./piruett.w"

void ledCntl(int8_t state)
{
PORTB= state?PORTB|(1<<PORTB5):PORTB&~(1<<PORTB5);
}

/*:40*//*41:*/
#line 632 "./piruett.w"

void relayCntl(int8_t state)
{
PORTB= state?PORTB|(1<<PORTB0):PORTB&~(1<<PORTB0);
}

/*:41*//*42:*/
#line 640 "./piruett.w"

void larboardDirection(int8_t state)
{
if(state)
PORTD&= ~(1<<PORTD3);
else
PORTD|= (1<<PORTD3);

}

/*:42*//*43:*/
#line 652 "./piruett.w"

void starboardDirection(int8_t state)
{
if(state)
PORTD&= ~(1<<PORTD4);
else
PORTD|= (1<<PORTD4);
}

/*:43*//*44:*/
#line 663 "./piruett.w"

int16_t int16clamp(int16_t value,int16_t min,int16_t max)
{
return(value> max)?max:(value<min)?min:value;
}

/*:44*/
