bjornburton/champbot/(commit log)

2015-05-22 added models and feature list
    [champbotFeatureList.ods]
2015-05-23 added beginnings of SOW
    [champbotFeatureList.ods]
2015-05-23 added beginnings of dFMEA
    [dFMEA.ods]
2015-05-24 completed statement of work
    [Competition.ods]
2015-05-26 added to features
    [champbotFeatureList.ods]
2015-05-29 added some details
    [champbotFeatureList.ods, dFMEA.ods]
2015-06-01 beginning to define firmware
    [champbotFeatureList.ods]
2015-06-03 added remote purchase
    [champbotFeatureList.ods]
2015-06-06 The Makefile is now setup for avrdude into the Pro Trinket's emulation of usbtiny for MCU atmega328p.
    The code now has control of the LED! This new trinket has the LED on PB5
    rather than PB1. So far, so good.
2015-06-07 updated buget
    [champbotFeatureList.ods]
2015-06-09 updated featues and dFMEA a bit
    [champbotFeatureList.ods, dFMEA.ods]
2015-06-12 A simple test for interrupts, so far
2015-06-19 added new h-bridge spend
    [champbotFeatureList.ods]
2015-06-19 added a failure mode: o ring
    [dFMEA.ods]
2015-06-23 interrupt is working.
2015-06-24 changed from C99 to C11. Interesting to note that this is 32 years newer than Arduino!
2015-06-27 set LED to change with ch1duration
2015-06-27 Had lead channel swapped with lag---corrected that
    [piruett.c]
2015-06-27 added calibration to scale the values to 8 bits. Some protection and some notes.
2015-06-27 Fixed a comment or two
    [piruett.c]
2015-06-27 Added prototypes for limiter() and scale()
2015-07-03 just using the spreadsheet
    [champbotFeatureList.ods]
2015-07-05 Added timer counter 0 port setup for use as two phase-correct pwms.
    Finished timer counter 0 addition into main.
    Added setPwm()..
    Corrected WGM setting.
    Corrected OCR, since I had one PWM going to the wrong counter
    [piruett.c]
2015-07-05 Deleted old test code that served to inject interrupts.
    Set port D3 and D4 as port and starboard motor direction outputs.
    Added motor direction to setpwm, based on sign.
2015-07-08 added the watchdog, but there is a bug. Eliminated Scale structure and put components into input and trans structures.
    [piruett.c]
2015-07-08 moved the watchdog reset to the final, ch1 falling, edge. Added a lostSignal flag and assume no signal until the final edge.
    [piruett.c]
2015-07-09 changed name of ledcntl for ease of reading
2015-07-09 Added relay control. Added functions to control motor direction, for clarity.
2015-07-10 Added mode switch to piruett at zero thrust. Updated some text.
2015-07-29 corrected output pin numbers
2015-08-02 Inverted PWM in forward mode to support H-Bridge's direction side effect
    [piruett.c]
2015-08-09 added to documentation. Fixed decisiontree for piruet.
    [piruett.c]
2015-08-09 updated some PWM details
2015-08-09 added the schematic for owm glue
2015-08-09 changed comparators to Set on match. Changed PWM setup so that PWM is not inverted in Reverse.
    [piruett.c]
2015-08-10 made COM0A/B0 set (1) for inverted PWM; I thought I had already
    [piruett.c]
2015-08-11 reverse larboard value so in piruett the props run counter.
    Added piruett lock feature.
    [piruett.c]
2015-08-12 added lock feature to piruett. Added clamping function to neaten the code.
    Changed expansion file in Makefile to include a wild card for compiler updates. This is for Egypt.
2015-08-17 updated spreadsheet
    [champbotFeatureList.ods]
2015-08-17 updated dFMEA
    [dFMEA.ods]
2015-09-02 updated costs
    [champbotFeatureList.ods]
2015-09-07 added RC data. Updated costs and dfmea.
    [champbotFeatureList.ods, dFMEA.ods]
2015-09-24 updated dfmea and created pdf
    [dFMEA.ods]
2016-09-30 Final for ChampBot 2015
    [dFMEA.ods]
